rogerboe/Mitsubishi-Kaiteki-Heat-Pump-Remote-Temperature-Sensor/images/ESP32B showing Bluetooth Lost.jpeg

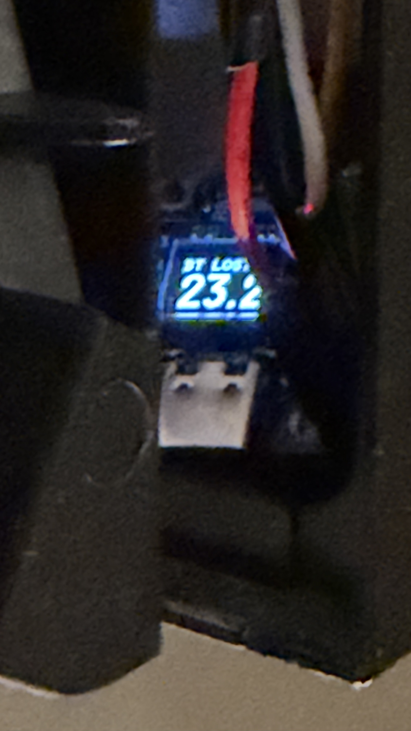
images/ESP32B showing Bluetooth Lost.jpeg
