rogerboe/Mitsubishi-Kaiteki-Heat-Pump-Remote-Temperature-Sensor/images/IMG_8AB06C49-728F-47EC-93C5-86B6CF2B736E.jpeg

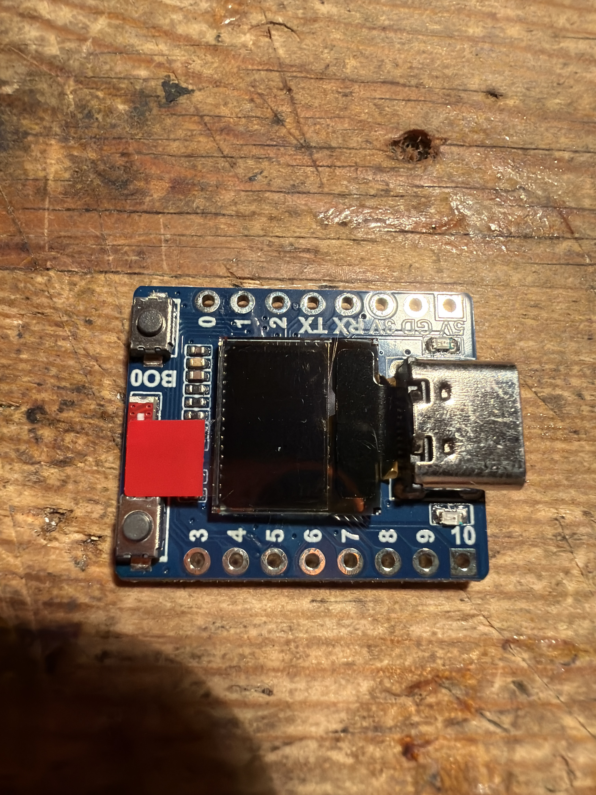
images/IMG_8AB06C49-728F-47EC-93C5-86B6CF2B736E.jpeg
