rogerboe/Mitsubishi-Kaiteki-Heat-Pump-Remote-Temperature-Sensor/images/ESP32A showing temperature in casing.jpeg

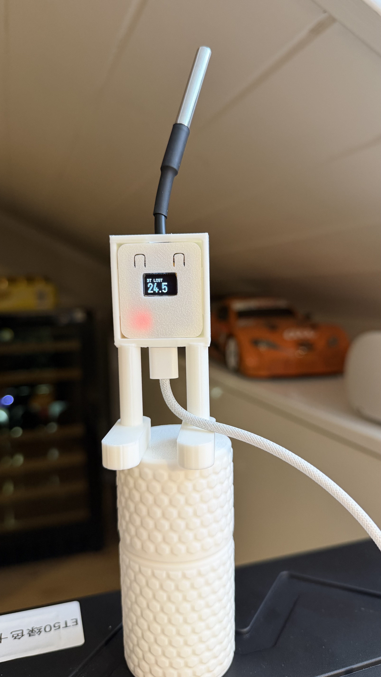
images/ESP32A showing temperature in casing.jpeg
