rogerboe/Mitsubishi-Kaiteki-Heat-Pump-Remote-Temperature-Sensor/images/ESP32B connected to CN105.jpeg

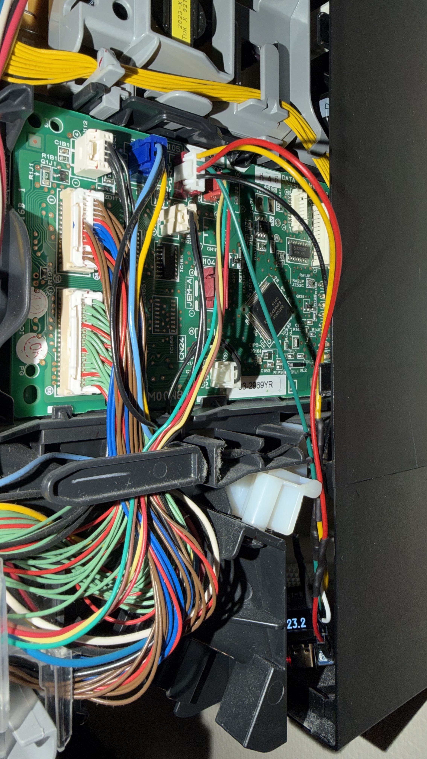
images/ESP32B connected to CN105.jpeg
