rogerboe/Mitsubishi-Kaiteki-Heat-Pump-Remote-Temperature-Sensor/images/CN105 and DS18b20 wiring to ESP32.png

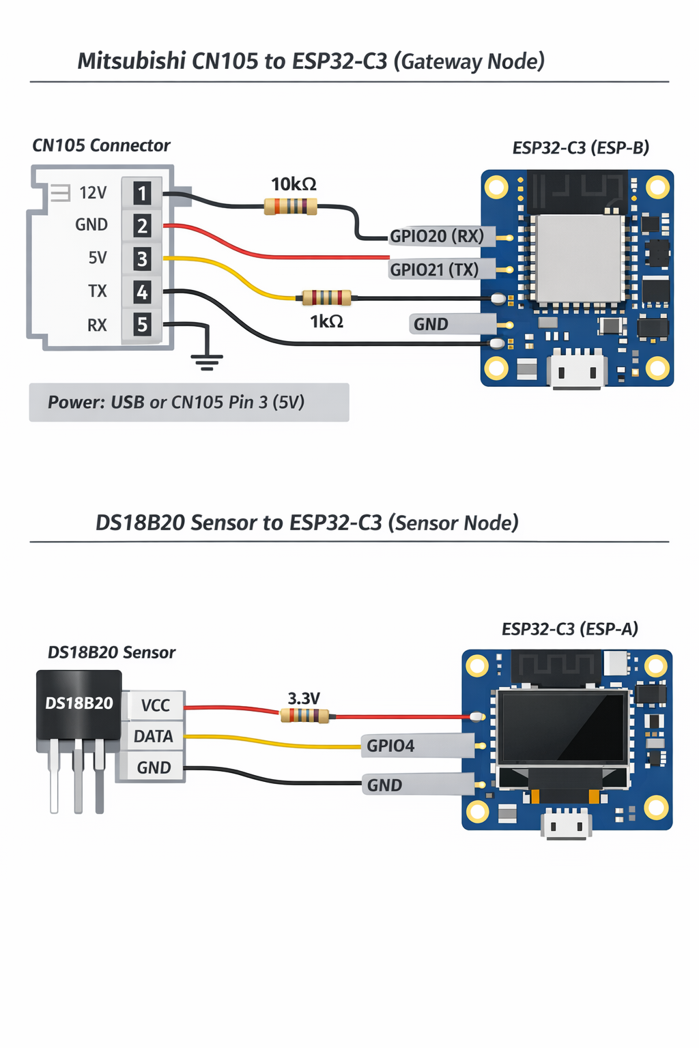
images/CN105 and DS18b20 wiring to ESP32.png
