rogerboe/Mitsubishi-Kaiteki-Heat-Pump-Remote-Temperature-Sensor/(commit log)

2026-04-14 Add files via upload
    This Arduino file is used for ESP 32 B located inside the heat pump connected to the CN105 connector.
2026-04-14 Add files via upload
    This Arudino file is used for ESP32 A sending the temperature read by the temperature sensor over Bluetooth to ESP32 B located in the heat pump.
2026-04-14 Rename CN105 and DS18b20 wiring to ESP32.png to images/CN105 and DS18b20 wiring to ESP32.png
2026-04-14 Rename IMG_0262.jpeg to Temperature sent over BT from A to B.jpeg
2026-04-14 Rename IMG_0464.jpeg to ESP32A showing temperature in casing
2026-04-14 Rename IMG_0467.jpeg to ESP32B connected to CN105
2026-04-14 Rename IMG_0468.jpeg to ESP32B showing Bluetooth Lost
2026-09-07 Rename ESP32A showing temperature in casing to ESP32A showing temperature in casing.jpg
    Renamed to .jpg
2026-09-07 Delete images/ESP32A showing temperature in casing.jpg
    0 byte file
2026-09-07 Delete images/ESP32B connected to CN105
    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
2026-09-07 Delete images/ESP32B showing Bluetooth Lost
    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
